SB-Colostate/CS370-plant-watering/(commit log)

2026-09-26 M1: Draft problem memo, team rules, and first transcript
    Rewrite PROBLEM.md as the Milestone 1 draft memo (user, problem, why a
    device, sensor cooperation, mechanisms E and D, risk). Add ADC and
    electrical notes plus new hard constraints and workflow rules to
    CLAUDE.md, list the ADC in README.md, and add Jim's raw Claude Code
    session transcript.
2026-10-29 Milestone 2: Uno reads soil + ultrasonic, Pi reads over USB serial
2026-10-30 M3: store record format (32-byte LE record, CRC-32/IEEE) + tests
    Encode/decode field by field; decode rejects bad magic or CRC. Tests cover
    the CRC check value, byte layout, round trip, every single-bit flip, and an
    all-zero (hole) record.
2026-10-30 M3: plantctl status|tail (read-only) + integration test
    status shows record count, writer lock state, latest soil/level with
    age, last START/RECOVERED/GAP, and any torn tail without touching it.
    tail N prints the last N records. it_plantctl.sh checks output, the
    no-modify guarantee, and exit codes. RUN now flushes stdout so test
    output interleaves correctly with expected stderr.
2026-10-30 M3: sampler + hub over Unix datagram socket, parse tests, pipeline test
    sampler: raw 9600 termios, strict line parser, discards the first line
    after open, exits 3 on EOF/EIO or no valid frame. hub: store_open
    recovery, binds hub.sock, appends each datagram, records SAMPLER_RESTART
    and GAP events, syncs per policy, exits 0 on SIGTERM. it_pipeline.sh
    drives fixture lines through a FIFO end to end.
2026-10-30 M3: live-run evidence; it_pipeline really tests the EOF exit path
    The sampler inherited the test's FIFO write end, so it exited via the
    5 s frame timeout, not EOF, and the test still passed. Close fd 3 for
    the sampler and require the EOF message.
2026-10-30 M3: docs match what was built; recovery demo evidence
    CLAUDE.md gets the real build/test commands. DESIGN.md: both sensors on
    the Uno with one sampler for M3, single seq-ordered log file (no RTC),
    seq check in recovery, supervisor marked not started, and the ownership
    map shows store/hub/plantctl/sampler were written in Jim's sessions with
    Claude Code, with Sam reviewing.
2026-10-30 M3: demo evidence, both sensors responding through the pipeline
